HydroNutri/Hardware/Main-Controller_Module/1.Document/Main-Controller_img.jpg

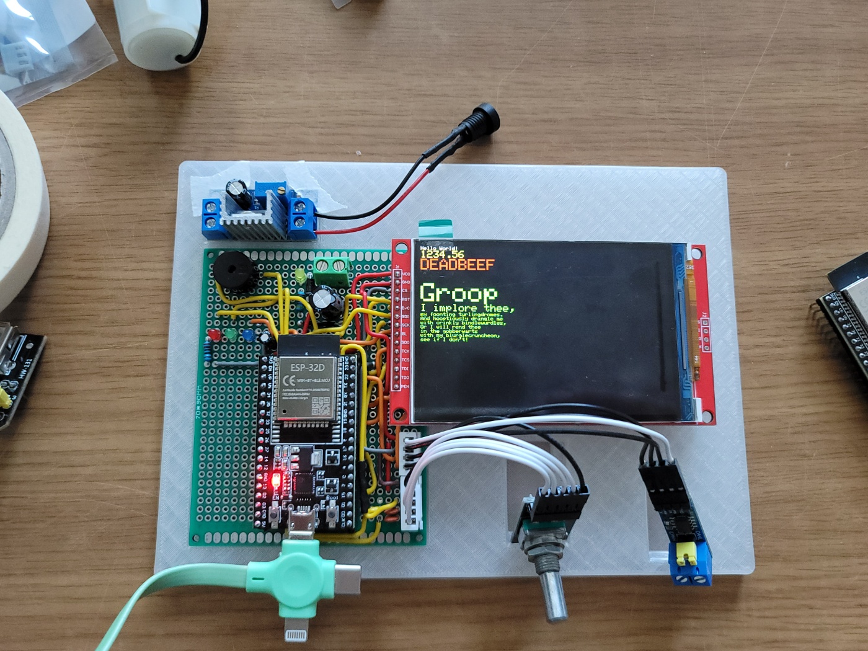
Main-Controller_Module/1.Document/Main-Controller_img.jpg
