HydroNutri/Hardware/Main-Controller_Module/1.Document/메인 컨트롤러 모듈 회로도 v0.1.0.pdf

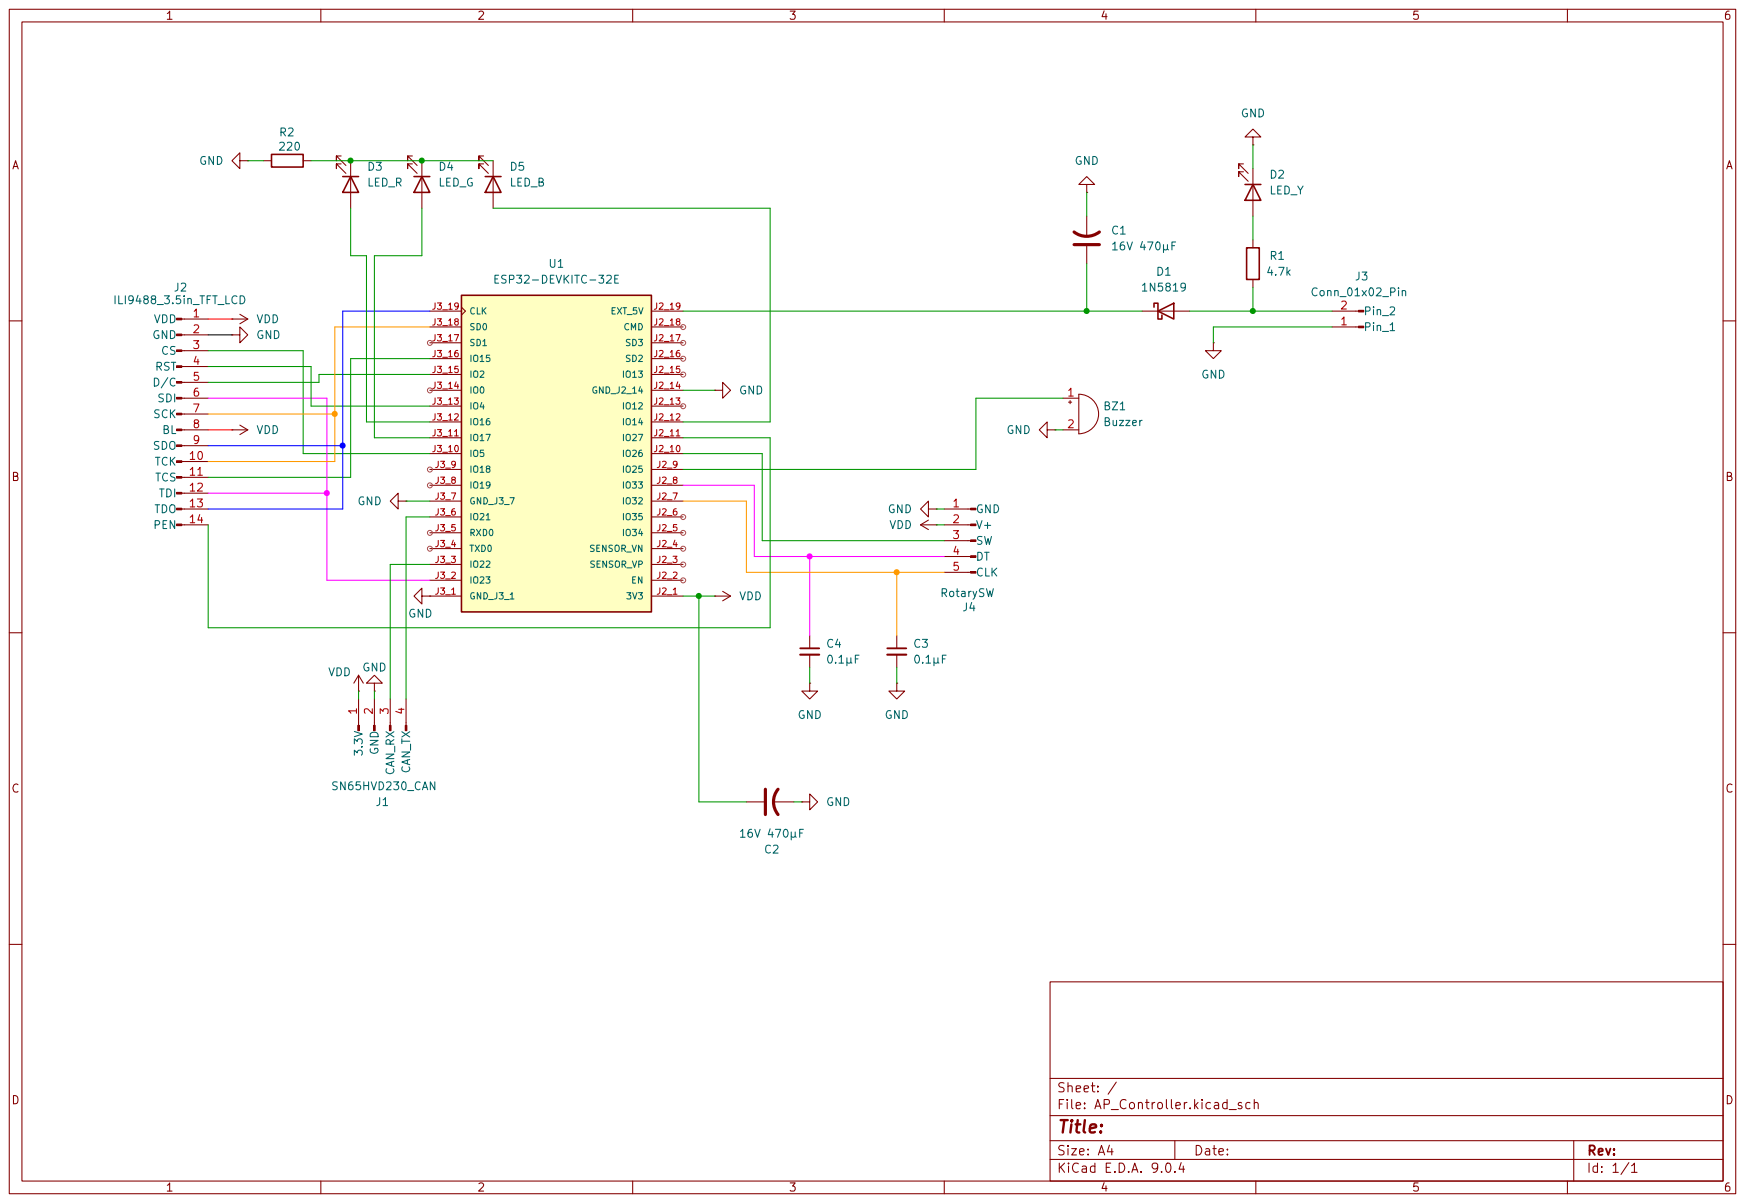
[picture p6: page 1]
