HydroNutri/Hardware/(commit log)

2025-11-05 메인컨트롤러 모듈 v0.1.0
2025-11-12 신호기 예제코드 추가
2025-11-12 신호기 핀맵 문서 추가
